creeeeeeeeep/RED_light-stick/modeling/old/CROWN_v12/README.md

# CROWN MINI CHEER STICK — v12

레드 왕관 + 화이트 확산 돔 · **전장 130.1mm** · 헤드 Ø47 · **손잡이 Ø17**

```bash
pip install trimesh manifold3d shapely matplotlib
python3 crown_v12.py     # STL 생성
python3 verify12.py      # 자동 검증
python3 plate12.py       # 출력 방향으로 정렬
```

---

## v11 → v12 : 배선을 바꿨더니 손잡이가 얇아졌습니다

v11은 **커넥터가 손잡이 구멍을 통과해야** 조립이 됐습니다. 그게 굵기를 정하고 있었습니다.

| | 통과해야 하는 것 | 필요 구멍 | 손잡이 |
|---|---|---|---|
| v11 (연장 케이블) | 몰드 12.4×7.6 (대각선 14.5) | Ø15 | Ø19 |
| **v12 (직결)** | **선 6가닥** | Ø13* | **Ø17** |

\* 구멍 Ø13은 선이 아니라 **손잡이 끝 암 브레이크아웃**(11×5, 대각선 12.1)이 정합니다.

**배선**: 보드의 `5V` `GND` `GPIO19(D-)` `GPIO20(D+)` 패드에 직접 4가닥 →
손잡이 구멍을 타고 내려가 끝의 USB-C 암 브레이크아웃으로. 버튼 2가닥 추가.

덤으로 **밴드 옆 플러그 자리가 통째로 사라졌고**, 뚜껑 안 케이블 통로도 없어져
뚜껑이 4.6 → 2.6mm, 밴드가 15.0 → 13.8mm로 얇아졌습니다.

### 꼭 확인할 것
- **GPIO19·20과 5V·GND가 외부로 노출**돼 있는지 (20핀 헤더 중)
- **CC 저항** — 암 브레이크아웃에 CC1/CC2 → GND **5.1kΩ 두 개**가 있어야
  C-to-C 케이블에서 전원이 나옵니다. A-to-C만 쓸 거면 없어도 됩니다
- **D+/D- 는 짝지어서** (가능하면 꼬아서) 배선. 60mm라 USB 2.0 풀스피드엔 여유
- 펌웨어는 **조립 전에 보드 자체 USB-C로** 굽습니다

---

## 내부 적층이 밴드 높이를 정합니다

```
뚜껑 2.6 + 스프링 2.2 + 보드 5.5 + 걸림탭 1.6 + 돔립 1.9 = 13.8
```

스프링 높이 2.2는 **링(0.6) 위로 선이 지나갈 1.6mm**를 확보한 값입니다.
스프링 잎은 변 중앙 4곳에 있으니 **선은 모서리(45°)로** 지나가게 하세요.

---

## 파트 (8종)

| 파일 | 색 | 크기 | 부피 | 출력 방향 | 서포트 |
|---|---|---|---|---|---|
| `01_dome_WHITE` | 화이트 | 37.7×37.7×30.9 | 4.65 | 개구부를 바닥에 | 없음 |
| `02_crown_RED` | 레드 | 47.7×49.7×37.4 | 15.78 | 밑면 바닥 | **없음** |
| `03_lid_RED` | 레드 | 28.3×29.4×3.7 | 1.11 | 그대로 (후크 위로) | 없음 |
| `04_spring_RED` | 레드 | 24.8×24.8×3.0 | 0.15 | 그대로 (잎 위로) | **없음** |
| `05_handle_RED` | 레드 | Ø17×64.7 | 8.26 | 스트랩 귀가 바닥 | 없음 |
| `06_btncap_RED` | 레드 | 11.3×10.3×2.1 | 0.12 | 눕혀서 | 없음 |
| `08_finial_RED` | 레드 | 9.6×9.6×12.0 | 0.43 | 다리가 바닥 | 없음 |
| `09_cross_RED` | 레드 | 13.0×19.5×3.6 | 0.50 | **반드시 눕혀서** | 없음 |

합계 **31.0cm³ ≒ 38g**. 필라멘트 2종(레드·화이트). 레이어 0.16mm, 인필 15%(돔 0%, 벽 3겹).

**전 파트 서포트 0**을 목표로 형상을 잡았습니다 — 뿔 끝 구슬은 구가 아닌 **티어드롭**(아래 45° 원뿔),
문양이 마름모인 것도 아래쪽이 45°라서, RED 명판은 밑면 45° 챔퍼.

**십자가는 반드시 눕혀서.** 세우면 층이 팔에 수직으로 쌓여 툭 치면 부러집니다.
눕히면 층이 팔과 나란해집니다. 팔 뿌리 단면 4.4×3.6 = **15.8mm²**.

---

## 사야 할 것

| 부품 | 규격 | 가격 |
|---|---|---|
| ESP32-S3-Matrix | Waveshare | 보유 3개 |
| **USB-C 암 브레이크아웃** | D+/D- 포함, 11×5 내외, CC 5.1k 내장 | 1~2천원 |
| 택트 스위치 | 6×6×3.7, **캡 달린 것** | 100원 |
| 배선 | AWG28~30, 6가닥 | — |

**GPIO 선택 (버튼)**: 쓰면 안 되는 핀 — 14(LED), 11·12(IMU I2C), 10·13(IMU IRQ),
0·3·45·46(스트래핑), **19·20(USB — 이번엔 배선에 씀)**, 26~32(플래시).
후보: **1, 2, 4~9, 15~18, 21**.

---

## 조립

1. 보드에 먼저 **펌웨어를 굽습니다** (보드 자체 USB-C)
2. 보드 패드에 4가닥(5V/GND/19/20) 납땜. 버튼 2가닥도
3. 왕관(02)을 뒤집고 보드를 넣습니다 (LED가 아래로). 선은 모서리로 빼둡니다
4. 스프링(04)을 보드 위에 올립니다. **잎이 보드를 향하게**. 선은 링 위로
5. 선을 뚜껑(03) 중앙 구멍으로 빼면서 뚜껑을 덮습니다. 후크 2개가 딸깍
6. 왕관을 세우고 돔(01)을 **위에서** 내려 립을 빛구멍에 꽂습니다
7. 피니얼(08) → 십자가(09) 순서로 꽂습니다
8. 선을 손잡이(05) 구멍으로 통과시키고 손잡이를 뚜껑 밑에 끼웁니다
9. 암 브레이크아웃에 4가닥을 납땜하고 손잡이 끝 자리에 밀어 넣습니다
10. 택트 스위치를 버튼 자리에 넣고 뚜껑(06)을 덮습니다

접착제·나사 없음. **납땜 10군데** (보드 4 + 브레이크아웃 4 + 버튼 2).

---

## 자동 검증 (`verify12.py`)

| 항목 | 결과 |
|---|---|
| 파트별 덩어리 수 | 전부 1 |
| 파트 간 간섭 | 버튼뚜껑 스냅 물림 16mm³ 외 **0** |
| 보드 ↔ 왕관 / 뚜껑 | 0 / 0 |
| LED 영역(20.6각) 침범 | **0** |
| 스프링이 미는 양 | 14mm³ (0.8mm 압축) |
| 보드 0.5mm 상승 | 10mm³ → 걸림탭이 막음 |
| 선다발(Ø4.4) 손잡이·뚜껑 통과 | 0 / 0 |
| 선이 스프링 위 통과 (45°) | **0** |
| 암 브레이크아웃 자리 | 0 |
| USB 플러그가 구멍으로 | 0 |
| 돔이 왕관 안으로 내려감 | 전 구간 0 |

---

## 실측 후 고칠 값 (`crown_v12.py` 상단)

| 값 | 현재 | 영향 |
|---|---|---|
| `BOARD_W` / `BOARD_T` | 25.0 / 5.5 | 두께는 스프링이 ±0.8mm 흡수 |
| `FB_W` / `FB_T` / `FB_L` | 11.0 / 5.0 / 14.0 | **손잡이 굵기를 정함** |
| `AP_W` / `AP_T` | 9.6 / 4.6 | USB 플러그 구멍 |
| `BTN_POS` | (±8, −8) | BOOT/RESET 접근 구멍 |
| `LED_W` | 20.6 | LED 매트릭스 한 변 |

---

## 남은 것

- BOOT/RESET은 뚜껑의 Ø3.2 구멍으로만 접근 (손잡이를 빼고 이쑤시개)
- 진주 장식, 손잡이 문양 추가
- 펌웨어 / 크롬 확장프로그램
