creeeeeeeeep/RED_light-stick/extension/확장 프로그램 출시 준비/promo_440x280.png

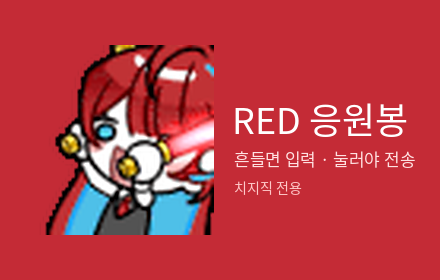
extension/확장 프로그램 출시 준비/promo_440x280.png
