creeeeeeeeep/RED_light-stick/extension/확장 프로그램 출시 준비/screenshot_1_chat.png

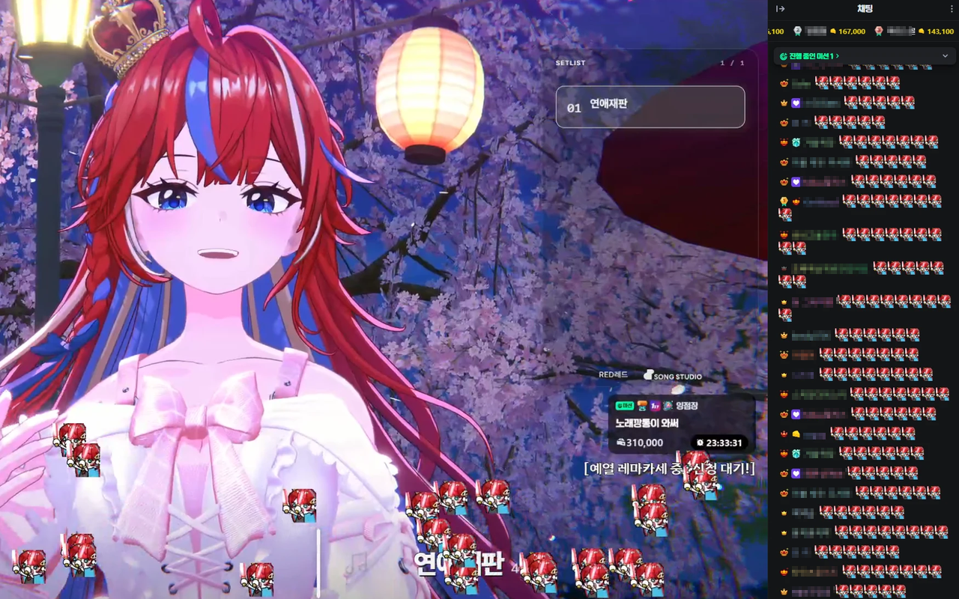
extension/확장 프로그램 출시 준비/screenshot_1_chat.png
