creeeeeeeeep/RED_light-stick/extension/확장 프로그램 출시 준비/screenshot_2_input_annotated.png

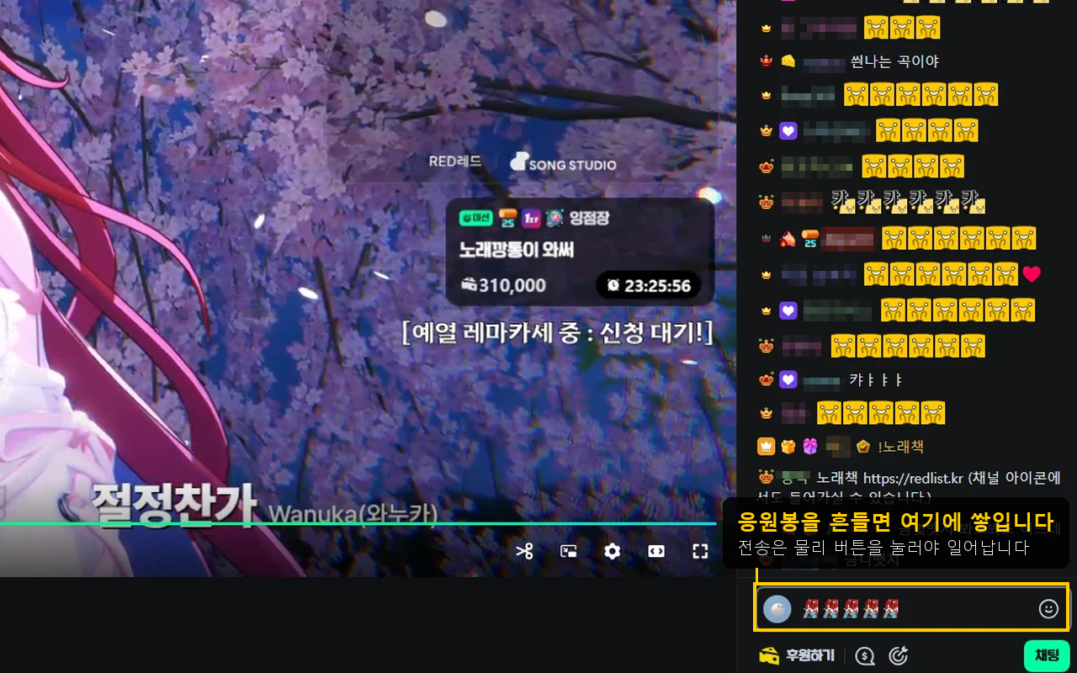
extension/확장 프로그램 출시 준비/screenshot_2_input_annotated.png
