creeeeeeeeep/RED_light-stick/modeling/CROWN_v20/10_fitgauge_RED.stl

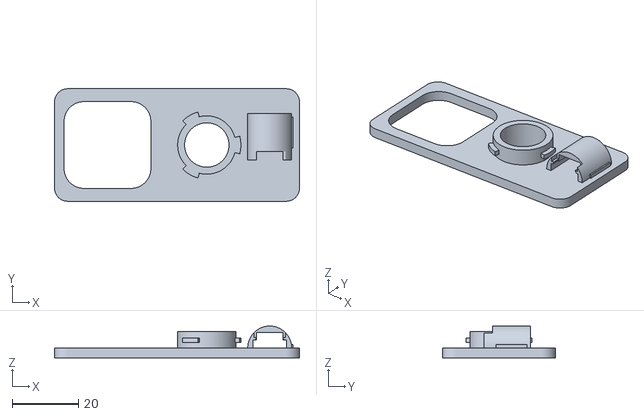
[picture p5: CAD file, 2026-11-01]
modeling/CROWN_v20/10_fitgauge_RED.stl
74.0 x 34.0 x 9.65
