creeeeeeeeep/RED_light-stick/modeling/CROWN_v20/05_handle_RED.stl

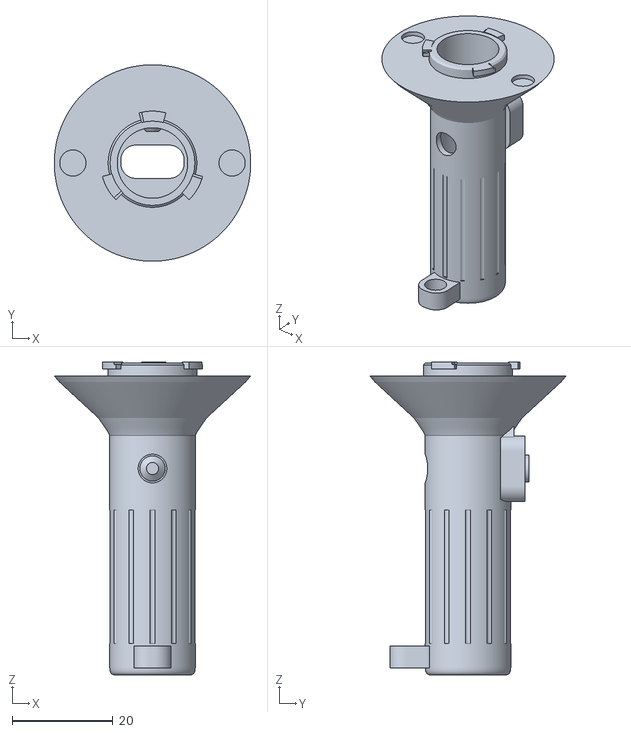
[picture p6: CAD file, 2026-11-01]
modeling/CROWN_v20/05_handle_RED.stl
39.0 x 39.0 x 62.2
