creeeeeeeeep/RED_light-stick/modeling/CROWN_v20/01_dome_WHITE.stl

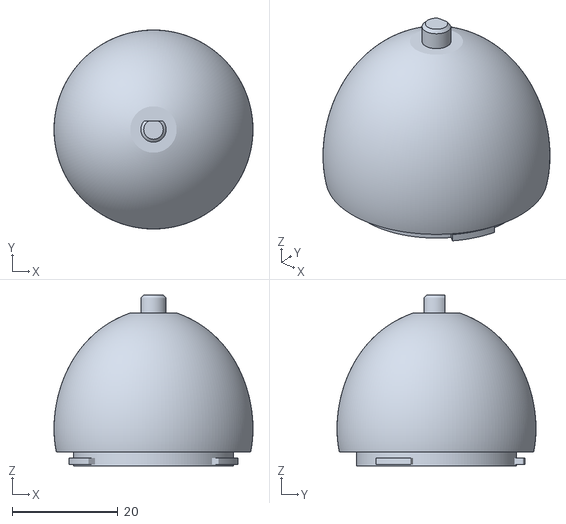
[picture p7: CAD file, 2026-11-01]
modeling/CROWN_v20/01_dome_WHITE.stl
37.7 x 37.7 x 32.4
