creeeeeeeeep/RED_light-stick/modeling/CROWN_v20/03_base_RED.stl

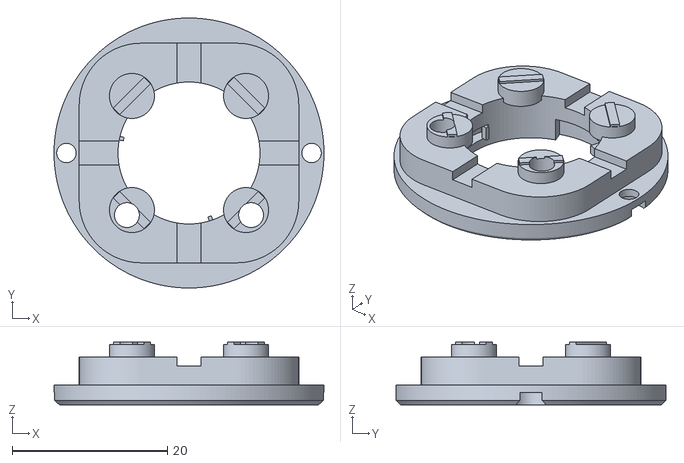
[picture p8: CAD file, 2026-11-01]
modeling/CROWN_v20/03_base_RED.stl
34.8 x 34.8 x 8.10
