creeeeeeeeep/RED_light-stick/modeling/CROWN_v20/08_finial_RED.stl

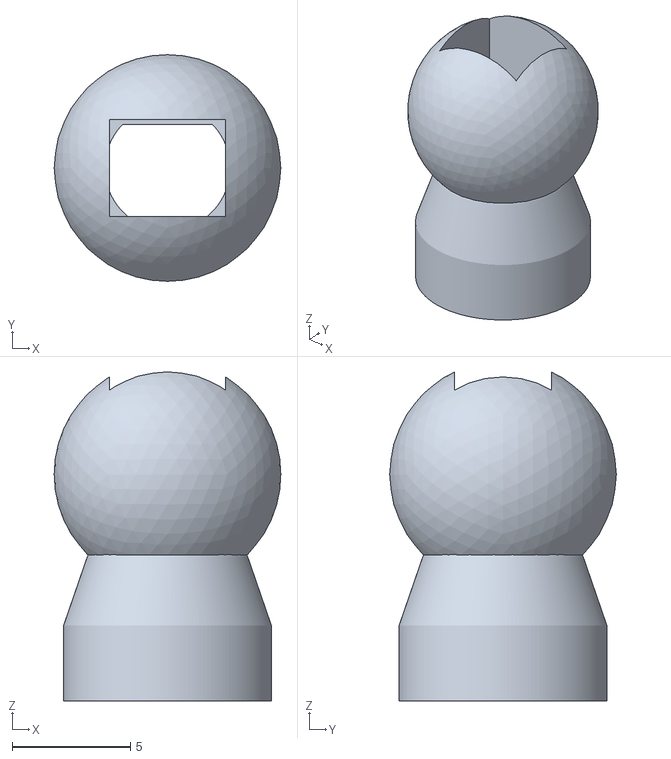
[picture p9: CAD file, 2026-11-01]
modeling/CROWN_v20/08_finial_RED.stl
9.60 x 9.60 x 13.9
