creeeeeeeeep/RED_light-stick/modeling/CROWN_v20/02_crown_RED.stl

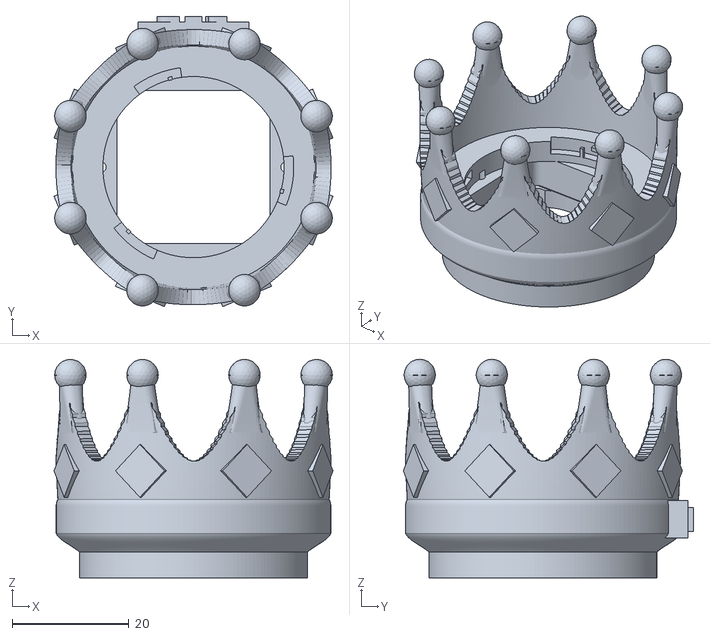
[picture p10: CAD file, 2026-11-01]
modeling/CROWN_v20/02_crown_RED.stl
47.7 x 49.7 x 37.4
