creeeeeeeeep/RED_light-stick/modeling/CROWN_v20/07_carrier_RED.stl

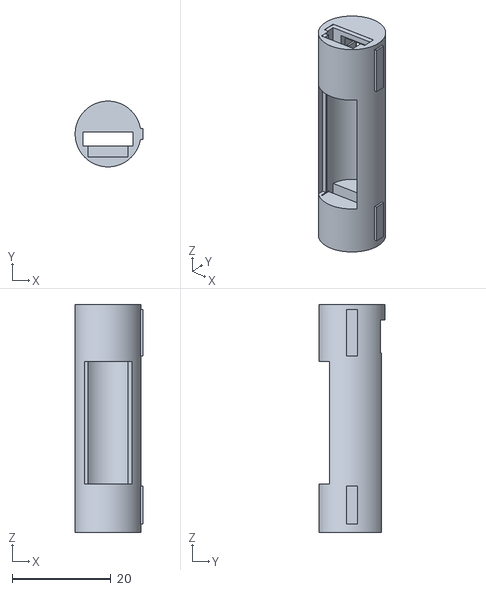
[picture p11: CAD file, 2026-11-01]
modeling/CROWN_v20/07_carrier_RED.stl
13.7 x 13.3 x 46.1
