creeeeeeeeep/RED_light-stick/modeling/CROWN_v20/11_btntest_RED.stl

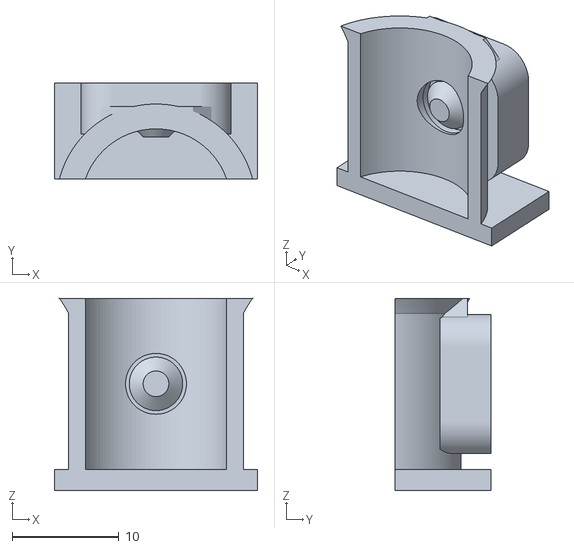
[picture p12: CAD file, 2026-11-01]
modeling/CROWN_v20/11_btntest_RED.stl
19.0 x 9.00 x 18.0
