creeeeeeeeep/RED_light-stick/modeling/old/CROWN_v12/06_btncap_RED.stl

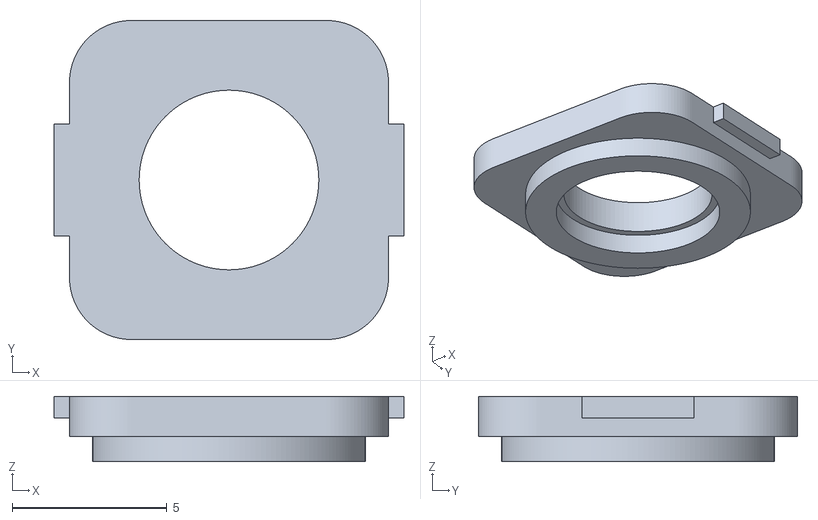
[picture p13: CAD file, 2026-11-01, an earlier design]
modeling/old/CROWN_v12/06_btncap_RED.stl
11.3 x 10.3 x 2.10
