creeeeeeeeep/RED_light-stick/modeling/old/v18_print/10_fitgauge_RED.stl

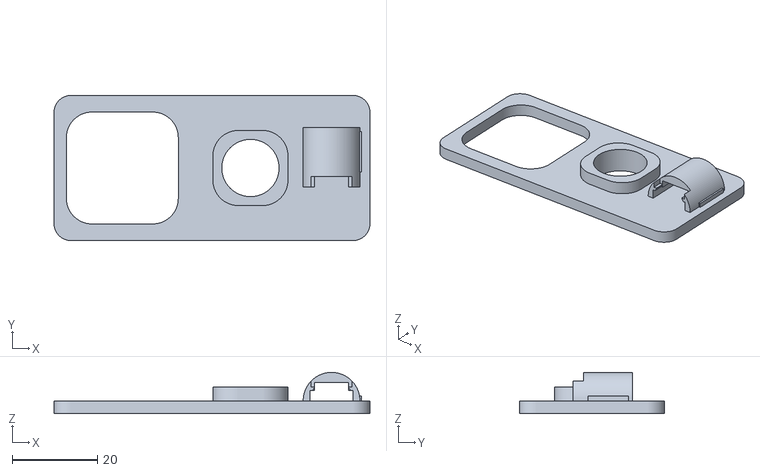
[picture p15: CAD file, 2026-11-01, an earlier design]
modeling/old/v18_print/10_fitgauge_RED.stl
74.0 x 34.0 x 9.65
