creeeeeeeeep/RED_light-stick/modeling/old/CROWN_v12/05_handle_RED.stl

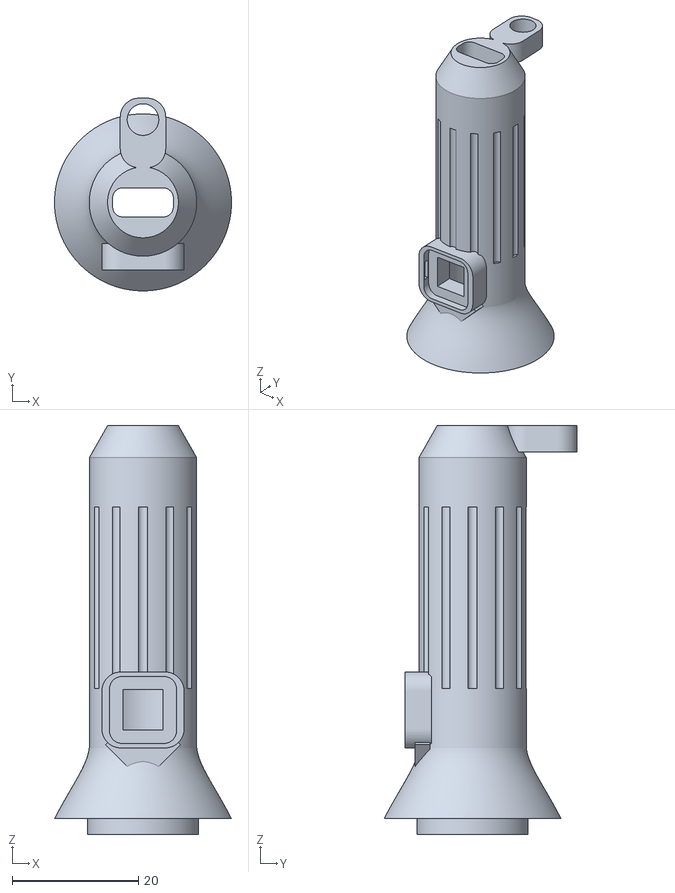
[picture p16: CAD file, 2026-11-01, an earlier design]
modeling/old/CROWN_v12/05_handle_RED.stl
28.0 x 30.5 x 64.7
