creeeeeeeeep/RED_light-stick/modeling/old/v17_print/09_cross_RED.stl

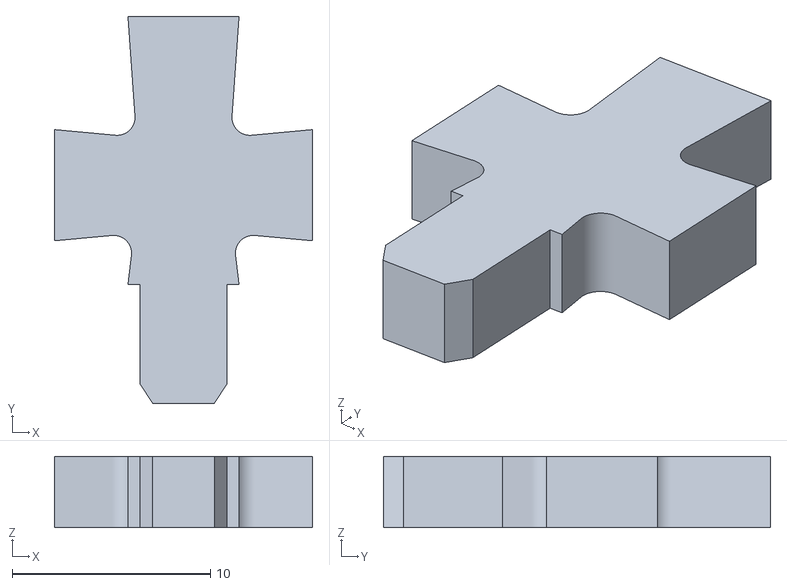
[picture p17: CAD file, 2026-11-01, an earlier design]
modeling/old/v17_print/09_cross_RED.stl
13.0 x 19.5 x 3.60
