creeeeeeeeep/RED_light-stick/modeling/old/v18_print/07_carrier_RED.stl

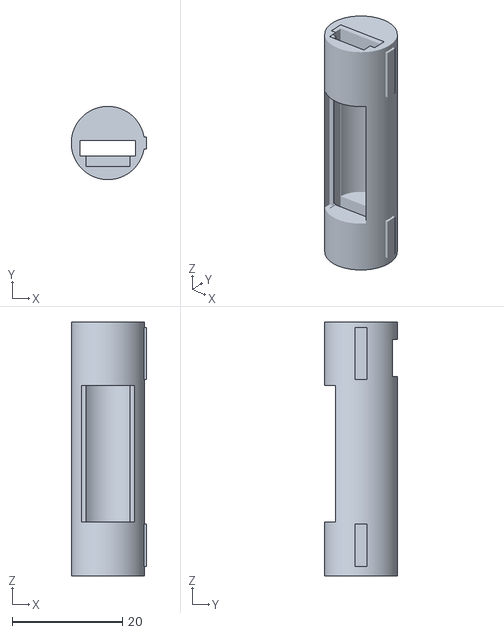
[picture p18: CAD file, 2026-11-01, an earlier design]
modeling/old/v18_print/07_carrier_RED.stl
13.7 x 13.3 x 46.1
