creeeeeeeeep/RED_light-stick/modeling/old/CROWN_v12/02_crown_RED.stl

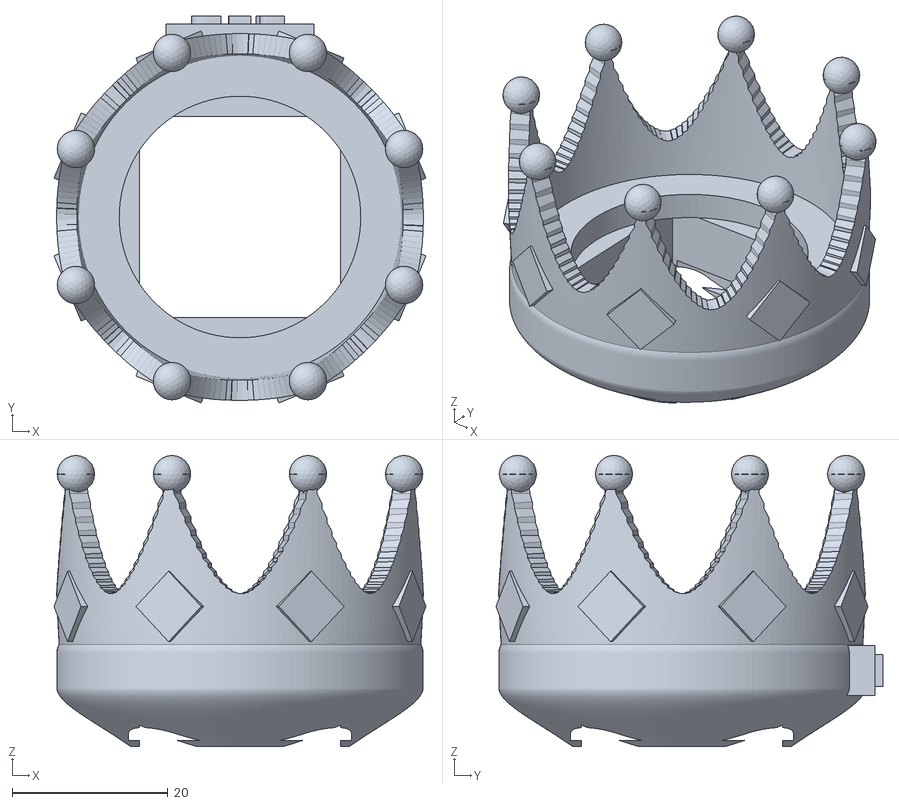
[picture p19: CAD file, 2026-11-01, an earlier design]
modeling/old/CROWN_v12/02_crown_RED.stl
47.7 x 49.7 x 37.4
