creeeeeeeeep/RED_light-stick/modeling/old/v17_print/01_dome_WHITE.stl

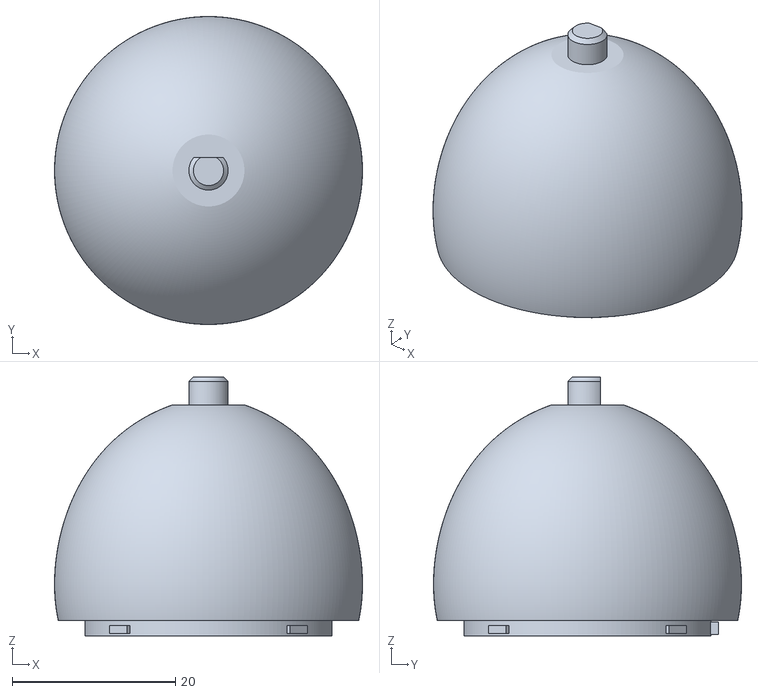
[picture p20: CAD file, 2026-11-01, an earlier design]
modeling/old/v17_print/01_dome_WHITE.stl
37.7 x 37.7 x 31.7
