creeeeeeeeep/RED_light-stick/modeling/old/v18_print/06_button_RED.stl

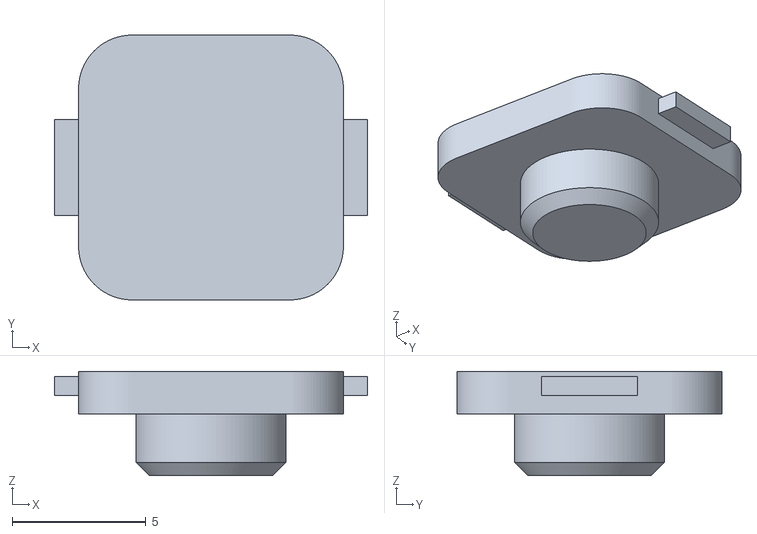
[picture p21: CAD file, 2026-11-01, an earlier design]
modeling/old/v18_print/06_button_RED.stl
11.7 x 9.90 x 3.91
