creeeeeeeeep/RED_light-stick/modeling/old/CROWN_v12/08_finial_RED.stl

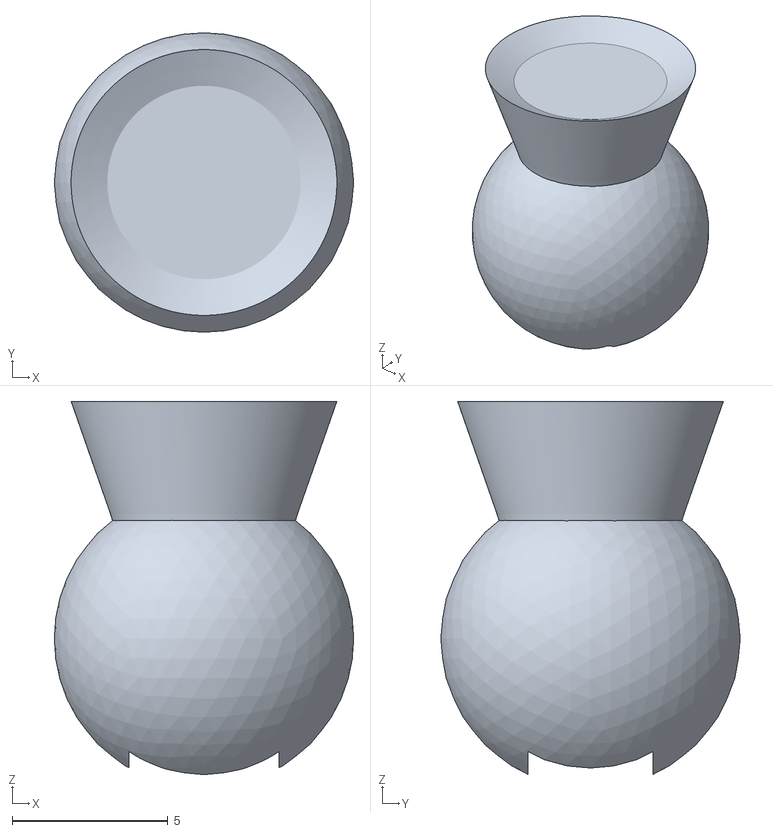
[picture p22: CAD file, 2026-11-01, an earlier design]
modeling/old/CROWN_v12/08_finial_RED.stl
9.60 x 9.60 x 12.0
