creeeeeeeeep/RED_light-stick/(list of files, cad)

Other CAD files:
modeling/old/CROWN_v12/01_dome_WHITE.stl
modeling/old/CROWN_v12/03_lid_RED.stl
modeling/old/CROWN_v12/09_cross_RED.stl
modeling/old/v17_print/04_spring_RED.stl
modeling/old/v17_print/05_handle_RED.stl
modeling/old/v18_print/01_dome_WHITE.stl
modeling/old/v18_print/02_crown_RED.stl
modeling/old/v18_print/03_lid_RED.stl
modeling/old/v18_print/04_spring_RED.stl
modeling/old/v18_print/08_finial_RED.stl
