creeeeeeeeep/RED_light-stick/modeling/old/v17_print/README.md

# CROWN MINI CHEER STICK — v17

레드 왕관 + 화이트 확산 돔 · **전장 130.1mm** · 헤드 Ø47 · 손잡이 Ø17

```bash
pip install trimesh manifold3d shapely matplotlib
python3 crown_v17.py    # STL 생성
python3 verify17.py     # 자동 검증 (출력성 검사 포함)
python3 plate17.py      # 출력 방향으로 정렬
```

---

## 왕관이 떨어진 이유 — 첫 층이 36mm², 그것도 4조각

재봤습니다.

```
   z(모델)   단면적    섬 수
   -0.8      36.5      4     ← 첫 층. 조각 하나당 9mm²
   -0.4      51.1      4
   +0.8      86.1      4
   +1.2      43.0      4
   +2.8     239.0      4
   +3.2     312.1      1     ← 여기서야 하나로 붙음
```

**첫 3mm 를 4개의 얇은 조각이 따로따로 올라가다가 z=3.2 에서 만납니다.**
조각 하나가 9mm² 니까 브림 없이는 붙어 있을 수가 없고,
붙어 있어도 그 얇은 기둥이 층 접착력만으로 버티다 갈라집니다.

### 그런데 원인이 하나 더 있었습니다 — 뚜껑이 애초에 못 들어갔습니다

같은 자리에서 검사해보니:

```
   뚜껑을 아래에서 위로 올려봄
   z-4 : 4.03 mm3   z-2 : 40.48 mm3   z-1 : 40.05 mm3   ← 막힘
```

**뚜껑(28.3)이 왕관 밑 구멍(26.2)보다 큽니다.** 물리적으로 못 들어갑니다.
제가 검증에서 "조립 위치에서 겹치나"만 봤고 **"거기까지 갈 수 있나"** 는 안 봤습니다.
지난번 손잡이 바닥과 똑같은 실수입니다. 이제 두 검사 다 넣었습니다.

### 진짜 원인 : 목이 보드보다 얇았습니다

```
   보드 25×25 → 대각선 반지름 17.68
   보드 자리 26.2 사각 → 모서리 반지름 18.53
   왕관 목 (z≈0) 바깥 반지름 ................ 14.0   ← 여기가 문제
```

**보드가 지나가는 통로의 모서리(18.53)가 왕관 바깥(14.0)보다 밖에 있습니다.**
그러니 그 높이에서는 재료가 남을 수가 없습니다. 4조각은 그 나머지 부스러기였습니다.

브림으로 덮을 문제가 아니라 **목을 넓혀야** 하는 문제입니다.

---

## 고친 것 : 밑에 Ø39 직선 스커트

| | v16 | v17 |
|---|---|---|
| 왕관 밑 지름 | Ø28 | **Ø39** |
| 첫 층 단면 | 36.5mm² · **4조각** | **402mm² · 1조각** |
| 첫 3mm 단면 | 36 → 239 (조각) | **402 일정 (통짜)** |
| 뚜껑 삽입 | **막힘 40mm³** | **전 구간 0** |
| 보드 삽입 | (검사 없었음) | **전 구간 0** |

- 밑에서 **z=3.4 까지 직선 원통** → 첫 3mm 가 단면 변화 없이 통짜로 올라갑니다
- 보드 자리 모서리를 R1.2, 뚜껑 모서리를 R8.0 으로 라운드 → 스커트 안에 들어옵니다
- 뚜껑 자리를 **밑면까지 관통** → 뚜껑이 실제로 들어갑니다

### 실루엣은 거의 그대로입니다

원래도 손잡이(Ø17) → 칼라 → 헤드(Ø47) 로 벌어지는 형태였고,
**벌어지는 구간의 경계만 위로 올라갔습니다.** 전체 윤곽은 같습니다.
칼라가 베지어 곡선 → **직선 테이퍼**로 바뀌어 오히려 깔끔해졌습니다.

칼라 오버행을 재보니 v16 은 **56°** 였습니다 (서포트 필요, 아마 여기도 지저분했을 겁니다).
칼라를 길게 빼서 **40°** 로 내렸습니다. 서포트 필요 없습니다.
그만큼 전송 버튼은 z −18 → **−22** 로 내려갔습니다 (칼라를 피해서).

---

## 슬라이서

| 파트 | 설정 |
|---|---|
| `02_crown_RED` | **벽 4겹**, 인필 15%, 첫 층 0.24mm, **브림 5mm 권장** |
| `01_dome_WHITE` | 벽 3겹, **인필 0%** |
| `05_handle_RED` | 벽 3겹, 브림 불필요 (바닥 Ø17 통짜) |
| `07_carrier_RED` | 벽 4겹 (얇고 길어서 벽이 강도를 정함) |
| 전 파트 | **서포트 없음** |

첫 층이 402mm² 면 브림 없이도 붙지만, 30개를 뽑을 거라 실패 하나가 아까우니 브림을 권합니다.

---

## 파트 (10종)

| 파일 | 색 | 크기 (출력 방향) | 부피 |
|---|---|---|---|
| `10_fitgauge_RED` | 레드 | 74.0×34.0×9.6 | 5.92 |
| `01_dome_WHITE` | 화이트 | 37.7×37.7×31.7 | 4.71 |
| `02_crown_RED` | 레드 | 47.7×49.7×37.3 | 16.62 |
| `03_lid_RED` | 레드 | 28.3×30.3×3.7 | 1.02 |
| `04_spring_RED` | 레드 | 24.8×24.8×3.0 | 0.15 |
| `05_handle_RED` | 레드 | 39.0×39.0×64.7 | 10.71 |
| `06_button_RED` | 레드 | 11.7×9.9×3.9 | 0.21 |
| `07_carrier_RED` | 레드 | 13.7×13.3×46.1 | 2.72 |
| `08_finial_RED` | 레드 | 9.6×9.6×13.9 | 0.48 |
| `09_cross_RED` | 레드 | 13.0×19.5×3.6 | 0.50 |

본체 합계 **37.1 cm³ ≒ 46 g** (v16 32.6 → 칼라가 커진 만큼 늘었습니다).

---

## 자동 검증에 추가한 항목

이번 실수의 패턴이 반복되니 **"목적지까지 갈 수 있나"** 검사를 전부 넣었습니다.

```
── ★ 출력성 (왕관) ──
   z -0.8 단면   402.0mm2  섬 1  OK
   z +0.2 단면   402.0mm2  섬 1  OK
   z +2.0 단면   402.0mm2  섬 1  OK
   z +3.0 단면   461.9mm2  섬 1  OK
   z +5.0 단면   812.5mm2  섬 1  OK
   뚜껑 본체가 밑에서 자리까지 : [0.0, 0.0, 0.0, 0.0, 0.0]
   보드가 밑에서 자리까지     : [0.0, 0.0, 0.0, 0.0, 0.0]
```

기존 항목(캐리어 통과·플러그 도달·스위치·배선·방향키)도 전부 0 유지.

---

## 조립 · 부품 · 실측 항목
v16 과 같습니다. 버튼 z 위치만 −18 → −22 로 바뀌었습니다.

## 남은 것
- 펌웨어 (IMU 흔들림 → CDC 시리얼, 버튼, LED, 밝기 상한)
- 크롬 확장프로그램 (Web Serial → 치지직 채팅 입력)
