creeeeeeeeep/RED_light-stick/modeling/old/v18_print/README.md

# CROWN MINI CHEER STICK — v18

레드 왕관 + 화이트 확산 돔 · **전장 131.1mm** · 헤드 Ø47 · 손잡이 Ø17

```bash
pip install trimesh manifold3d shapely matplotlib
python3 crown_v18.py    # STL 생성
python3 verify18.py     # 자동 검증
python3 plate18.py      # 출력 방향으로 정렬
```

---

## 스프링 — 서포트가 붙던 이유부터

v17 스프링은 **잎이 19° 경사로 올라가는 램프**였습니다.
제가 예전 README 에 "11° 라 서포트 불필요" 라고 적어놨는데 **틀린 계산이었습니다.**

```
   잎이 올라간 높이 2.4mm ÷ 잎 길이 7.0mm  →  수평에서 19°
   레이어 0.16mm 마다 안쪽으로 0.47mm 씩 허공으로 나감
   → 노즐 폭(0.4)보다 더 나가므로 슬라이서가 반드시 서포트를 붙인다
```

떼기 힘든 게 당연했고, 떼면서 0.6mm 짜리 잎이 휘어버리니 힘도 안 나왔습니다.

### 힘도 부족했습니다

```
   잎 4.0폭 × 0.6두께 × 7.0길이,  0.8mm 눌러서  →  5.0 N   (계산상)
```

계산상 5N 인데 서포트 자국 + 휨 때문에 실제로는 그 절반도 안 나왔을 겁니다.

---

## 고친 것 — 완전 평판 스파이럴

**두께 방향으로 경사진 부분이 하나도 없습니다.** 평평한 1.8mm 판 + 수직 원기둥 4개뿐입니다.

```
   ┌ 바깥 테두리 24.8각 (뚜껑 위에 그냥 앉음)
   │   ↘ 스파이럴 팔 4개 (75°, 폭 2.6, 두께 1.8) — 전부 같은 평면
   │       ↘ 팔 끝 패드 + 수직 기둥 Ø3.2 × 2.1  ← 보드를 여기가 민다
   └ 가운데 Ø12.2 뚫림 (배선 통로)
```

**팔이 눌리는 공간은 뚜껑이 제공합니다.** 뚜껑 윗면에 이미 있던 Ø21.2 × 1.3 릴리프
위로 팔이 떠 있어서, 0.7mm 눌려도 뚜껑에 안 닿습니다.

| | v17 | v18 |
|---|---|---|
| 형상 | 19° 램프 잎 | **완전 평판** |
| 두께 | 0.6 | **1.8** (3배) |
| 서포트 필요 면적 | 램프 전체 | **0.00 mm²** |
| 미는 힘 (계산) | 5.0 N | **13.6 N** |
| 응력 | — | 30 MPa (PLA 항복 50) — 눌러도 안 죽습니다 |

곡선 팔이라 비틀림도 같이 먹으므로 실제로는 계산보다 부드럽습니다. **체감 8~11 N** 예상.

### 힘 조절
`crown_v18.py` 위쪽에서 한 줄로 바꿉니다.

| 바꿀 값 | 효과 |
|---|---|
| `SPR_T` 1.8 → **2.0** | 힘 ×1.37 (24 N) |
| `SPR_T` 1.8 → **1.6** | 힘 ×0.70 (9.6 N) |
| `ARM_SWEEP` 75 → **65** | 힘 ×1.55 (팔이 짧아짐) |
| `ARM_SWEEP` 75 → **85** | 힘 ×0.68 |

너무 뻑뻑하면 `SPR_T` 를 1.6 으로, 더 꽉 잡고 싶으면 `ARM_SWEEP` 을 65 로.

### 밴드가 1mm 높아졌습니다
스프링이 두꺼워진 만큼 `SPR_H` 를 2.2 → **3.2** 로 올렸습니다.
보드 밑면과 스프링 테두리 사이 **1.4mm** 가 배선 통로입니다 (테두리에 0.9 깊이 홈 4개 추가).
밴드 13.8 → 14.8, 전장 130.1 → **131.1mm**.

---

## 파트 (10종)

| 파일 | 색 | 크기 (출력 방향) | 부피 |
|---|---|---|---|
| `10_fitgauge_RED` | 레드 | 74.0×34.0×9.6 | 5.92 |
| `01_dome_WHITE` | 화이트 | 37.7×37.7×31.7 | 4.71 |
| `02_crown_RED` | 레드 | 47.7×49.7×38.3 | 17.67 |
| `03_lid_RED` | 레드 | 28.3×30.3×3.7 | 1.02 |
| `04_spring_RED` | 레드 | 24.8×24.8×3.9 | 0.68 |
| `05_handle_RED` | 레드 | 39.0×39.0×64.7 | 10.71 |
| `06_button_RED` | 레드 | 11.7×9.9×3.9 | 0.21 |
| `07_carrier_RED` | 레드 | 13.7×13.3×46.1 | 2.72 |
| `08_finial_RED` | 레드 | 9.6×9.6×13.9 | 0.48 |
| `09_cross_RED` | 레드 | 13.0×19.5×3.6 | 0.50 |

본체 합계 **38.7 cm³ ≒ 48 g**. **전 파트 서포트 없음.**

### 스프링 출력 팁
평판이라 **인필 100% / 벽만으로** 뽑으세요 (0.68cm³ 라 어차피 금방입니다).
팔 폭이 2.6mm 니까 0.4 노즐로 벽 3겹이면 속이 꽉 찹니다. 인필 15% 로 두면
팔 속이 비어서 힘이 절반이 됩니다. **이게 제일 중요합니다.**

---

## 검증에 추가한 항목

```
── 스프링 ──
   스프링이 보드를 미는 양          :   21.29 mm3  (>0)
   스프링 ↔ 뚜껑 (안 눌린 상태)     :    0.00
   팔만 0.7mm 눌렸을 때 뚜껑에 닿나 :    0.00   ← 릴리프 충분
   아래 보는 면이 바닥 위에 있는 넓이:    0.00 mm2  ← 서포트 불필요
   가운데 배선 구멍                 : Ø 12.2 mm  (뚜껑 구멍 Ø13.4)
```

**"아래를 보는 면이 바닥면보다 위에 있는 넓이"** 를 재는 검사를 넣었습니다.
이게 0 이면 그 파트는 서포트가 필요 없습니다. v17 스프링은 여기서 걸렸을 겁니다 —
앞으로는 모든 파트에 이 검사가 돕니다.

기존 항목(왕관 출력성·뚜껑/보드 삽입·캐리어 통과·플러그 도달·스위치·방향키)도 전부 유지.

---

## 남은 것
- 펌웨어 (IMU 흔들림 → CDC 시리얼, 버튼, LED, 밝기 상한)
- 크롬 확장프로그램 (Web Serial → 치지직 채팅 입력)
