creeeeeeeeep/RED_light-stick/firmware/main/power.h

#pragma once

#include <stdbool.h>

#ifdef __cplusplus
extern "C" {
#endif

/*
 * LED 전류 예산을 실행 중에 정한다.
 *
 * ---------------------------------------------------------------------------
 * 왜 필요한가
 * ---------------------------------------------------------------------------
 * WS2812B 는 채널(R/G/B)마다 내부에 정전류 드라이버가 있어 하나가 약 20mA 를
 * 넘지 않는다. 하지만 '전체' 를 막아주는 것은 아무것도 없다. 64픽셀 x 3채널
 * 이면 이론상 3.8A 다. 총량을 지키는 것은 오직 이 펌웨어다.
 *
 * 그런데 얼마나 써도 되는지는 무엇에 꽂혀 있느냐에 달렸고, 봉은 그걸 모른다.
 *   - PC USB 포트        : 500~900mA 를 MCU 와 나눠 쓴다
 *   - 충전기 / 보조배터리 : 보통 1~3A
 *
 * ---------------------------------------------------------------------------
 * 어떻게 알아내는가
 * ---------------------------------------------------------------------------
 * 1. USB 호스트가 붙어 있으면 PC 다. 충전기는 전원만 주고 데이터는 없다.
 *    이걸로 첫 추정을 한다.
 *
 * 2. 그리고 실제로 겪어보고 배운다. 전류를 과하게 끌면 대개 타는 게 아니라
 *    전압이 주저앉아 보드가 리셋된다. 그 리셋은 esp_reset_reason() 으로
 *    구분되므로, 브라운아웃으로 죽었다면 한 단계 낮춰 NVS 에 적어둔다.
 *    몇 번 겪고 나면 그 급전 환경에서 안전한 값에 정착한다.
 *
 * 이 방식은 하드웨어를 추가하지 않는다. 전압을 재려면 분압 저항을 GPIO 에
 * 물려야 하는데 이 보드에는 그런 배선이 없다.
 */

/* app_main 에서 LED 를 켜기 전에 한 번. NVS 초기화 뒤에 불러야 한다. */
void power_init(void);

/* 지금 허용된 LED 총 전류 (mA) */
float power_budget_ma(void);

/* 부팅 직후 잠깐은 낮게 잡았다가 안정되면 목표치로 올린다 */
void power_tick(unsigned uptime_ms);

/* 사람이 읽을 상태 문자열 (STATUS 명령용) */
const char *power_status(void);

/*
 * 예산을 직접 정한다 (시리얼 LED 명령).
 *
 * 자동 추정이 보수적이라 답답할 때 쓴다. 가장 가까운 단계로 맞춰 NVS 에
 * 적어두므로 다음 부팅에도 유지되고, 그 값이 과해서 전압이 주저앉으면
 * 자동 학습이 다시 한 단계 내린다.
 *
 * ma 가 0 이면 학습값을 지우고 자동 추정으로 되돌린다.
 * 실제로 적용된 mA 를 반환한다.
 */
float power_set_budget(float ma);

#ifdef __cplusplus
}
#endif
