creeeeeeeeep/RED_light-stick/(commit log)

2026-09-01 크라운 응원봉 — 펌웨어, 중계 서버, 크롬 확장
    흔들면 치지직 채팅에 이모티콘이 쌓이고 버튼을 누르면 전송되는 응원봉.
    - firmware/ ESP-IDF(C). 중력 분해 기반 모션 인식 3종, 8x8 LED 연출,
    WiFi 설정 저장, pull 방식 OTA, LED 전력 예산 자동 판별
    - server/ aiohttp 중계. 봉의 HTTP POST 를 확장의 WebSocket 으로 넘긴다.
    방마다 토큰을 처음 접속 때 등록한다
    - chzzk/ 크롬 확장(MV3). 이모티콘 피커를 감춘 채 열어 대신 클릭한다.
    치지직이 입력창 직접 조작을 막기 때문이다
    전송은 반드시 사람이 버튼을 눌러야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
    [partitions.csv]
2026-09-01 폴더를 세 축으로 정리
    extension / firmware / server 를 최상위로 올렸다. 확장이 chzzk/ 아래에
    묻혀 있어서 저장소를 처음 보는 사람 눈에 세 덩어리가 안 보였다.
    치지직 조사 기록(API 구조, 프레임 캡처, 조사 스크립트)은 docs/ 로 옮겼다.
    구성 요소가 아니라 참고 자료다.
    문서의 옛 경로 참조도 같이 고쳤다.
2026-09-01 팬용 설치 안내 추가, 작업일지를 docs/ 로
    설치가이드는 응원봉을 받은 사람이 처음부터 끝까지 따라할 수 있게 썼다.
    파일 내려받기 → 확장 설치 → 굽기 → WiFi → 확인, 그리고 막히는 지점별
    해결책까지. 케이블이 충전 전용이거나 5GHz 를 고르는 것이 가장 흔한
    실패 원인이라 따로 짚었다.
    작업일지는 개발 기록이라 최상위에 있을 물건이 아니어서 docs/ 로 옮겼다.
2026-09-01 중계 서버를 팬 각자의 PC 에서 돌리는 방식으로
    봉도 브라우저도 팬의 집 안에 있으니 바깥에 서버를 둘 이유가 없었다.
    호스팅 비용, 집 IP 노출, 스트리머 PC 가 꺼지면 전부 멈추는 문제가 한꺼번에
    사라진다. 확장의 기본 주소가 원래 ws://localhost 였던 것도 이 구조를
    전제한 것이었다.
    팬이 감당해야 할 두 가지를 없앴다.
    - 서버가 접속한 확장에게 자기 LAN 주소를 알려주고, 설정 페이지가 그것으로
    서버 주소 칸을 자동으로 채운다. 팬이 자기 PC 의 IP 를 찾을 일이 없다.
    - 응원봉_서버_켜기.bat 을 더블클릭하면 파이썬·aiohttp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
2026-09-01 방(room) 개념을 없앤다
    방은 여러 팬이 하나의 서버를 나눠 쓸 때 서로를 가르려고 있던 것이다.
    서버가 팬마다 자기 컴퓨터에서 도는 지금 구조에서는 나눌 상대가 없다.
    그런데도 봉과 확장이 같은 방 이름을 들고 있어야 해서, 한쪽 설정만 지워지면
    둘 다 서버에 멀쩡히 붙은 채로 아무 일도 일어나지 않았다. 확장 폴더를 옮겨
    다시 설치하자 크롬이 새 ID 를 발급했고, 설정이 날아가면서 정확히 그 상태가
    됐다. 겉으로는 "연결됨" 이라 어디가 어긋났는지 보이지도 않았다.
    이제 봉 이벤트는 붙어 있는 확장 전부에게 간다.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
2026-09-01 문서를 현재 구조에 맞춘다
    방을 없앤 뒤에도 문서들이 옛 구조를 설명하고 있었다.
    - README: 설정 파일 설명을 다시 씀. 방·admin_token·rooms.json 얘기를 빼고
    왜 방이 없는지를 구조 설명에 넣었다. "아직 안 된 것" 에서 감수하기로 한
    것(팬 PC 상시 가동, 수동 펌웨어 갱신)을 따로 갈랐다 — 못 한 것과 안 하기로
    한 것은 다르다.
    - 설치 안내(md/html): 팬이 입력하는 것이 WiFi 비밀번호 하나뿐임을 명시.
    - 작업일지: 서버 구조를 다시 씀. 배포 전 항목에서 터널·도메인·서명을 뺐다 —
    서버가 각자 PC 에서 도는 이상 필요 없어졌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
2026-09-01 확장 버전을 펌웨어에 맞추고, 앞으로 같이 오르게 한다
    확장이 0.4.0 에 멈춰 있는 동안 코드가 네 번 바뀌었다. manifest.json 과
    inject.js 두 곳에 박혀 있었는데, inject.js 쪽은 콘솔 배너와 crown.diag() 에
    찍히는 값이라 진단할 때 실제와 다른 숫자를 보게 된다.
    둘 다 0.8.0 으로 맞췄다. 숫자가 같으면 "이 봉과 이 확장은 한 세트" 라고
    말할 수 있어서 팬에게 안내하기도 쉽다.
    따로 두면 반드시 또 어긋나므로 crown.ps1 의 version 명령이 확장 쪽도 같이
    올리게 했다. 저장소 구조(firmware/ 옆 extension/)면 자동으로 찾고, 펌웨어만
    떼어 쓰는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
2026-11-01 크롬 웹스토어 출시 준비
    아이콘을 확장에 넣고(16/32/48/128), manifest 에 icons 와 action.default_icon 을
    지정했다. 그동안 툴바에 회색 퍼즐 조각으로 떴던 이유다.
    리스팅 문구와 개인정보처리방침을 다시 썼다. 기존 초안이 실제 구현과 달랐다.
    적혀 있던 것 실제
    ------------------------------------ ----------------------------------
    봉이 red-stick.local:81 서버로 동작 봉은 서버를 안 연다. HTTP POST 로 보낸다
    확장이 봉에 직접 연결 확장은 PC 의 중계 서버에 붙는다
    중계 서버 언급 없음 없으면 아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
2026-11-01 크라운 3D 모델을 저장소에 넣는다
    지금까지 .gitignore 로 빼 두었는데, 그러면서 이 36MB 가 어디에도 백업이
    없는 상태였다. 디스크가 죽으면 v12 부터 v20 까지 설계가 통째로 날아간다.
    저장소에서 유일하게 복구 불가능한 자산이었다.
    old/ 의 zip 세 개는 뺐다. 같은 폴더의 사본이고 파일 수와 크기까지 일치하는
    것을 확인했다 — 7.7MB 를 잃는 것 없이 아낀다.
    Releases 에 붙이는 편이 저장소 이력에는 더 깔끔하지만, 이 환경에 gh 가 없어
    API 토큰 없이는 만들 수 없다. 모델을 자주 고치게 되면 그때 옮기는 게 맞다.
    README 에 modeling/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
2026-11-01 개인정보처리방침 주소를 실제 파일 위치에 맞춘다
    파일은 docs/ 안에 있는데 리스팅 자료는 저장소 최상위를 가리키고 있었다.
    GitHub Pages 를 켜도 그 주소로는 404 가 난다.
2026-11-01 출시용 스크린샷을 넣고 리스팅 자료를 대시보드에 맞춘다
    스크린샷 두 장을 1280x800 으로 맞추고 시청자 닉네임을 전부 모자이크 처리했다.
    공개 스토어 페이지에 남의 아이디가 그대로 박히는 것을 피한다.
    확장 이름은 manifest 에서 오므로 대시보드에서 고칠 수 없다. 자료에 적힌
    이름이 manifest 와 달라서 맞췄다. 대시보드가 따로 묻는 '단일 목적' 문구도 넣었다.
2026-11-01 조작 방식 변경의 착수 조건을 적어둔다
    버튼 위치는 모델링 팀과 협의해 정해졌고 디자인 중이다. GPIO 번호와 전송
    동작의 구체적 사양은 사용자가 주기로 했으므로, 그전에 추측해서 구현하지
    않는다. "손에 쥐어 봐야 정해진다" 던 기존 메모는 더 이상 맞지 않는다.
